wileycousins/clockblock/pcb/clockblock-pcb.sch

## KiCad design pcb/clockblock-pcb.sch (2014-01-02)

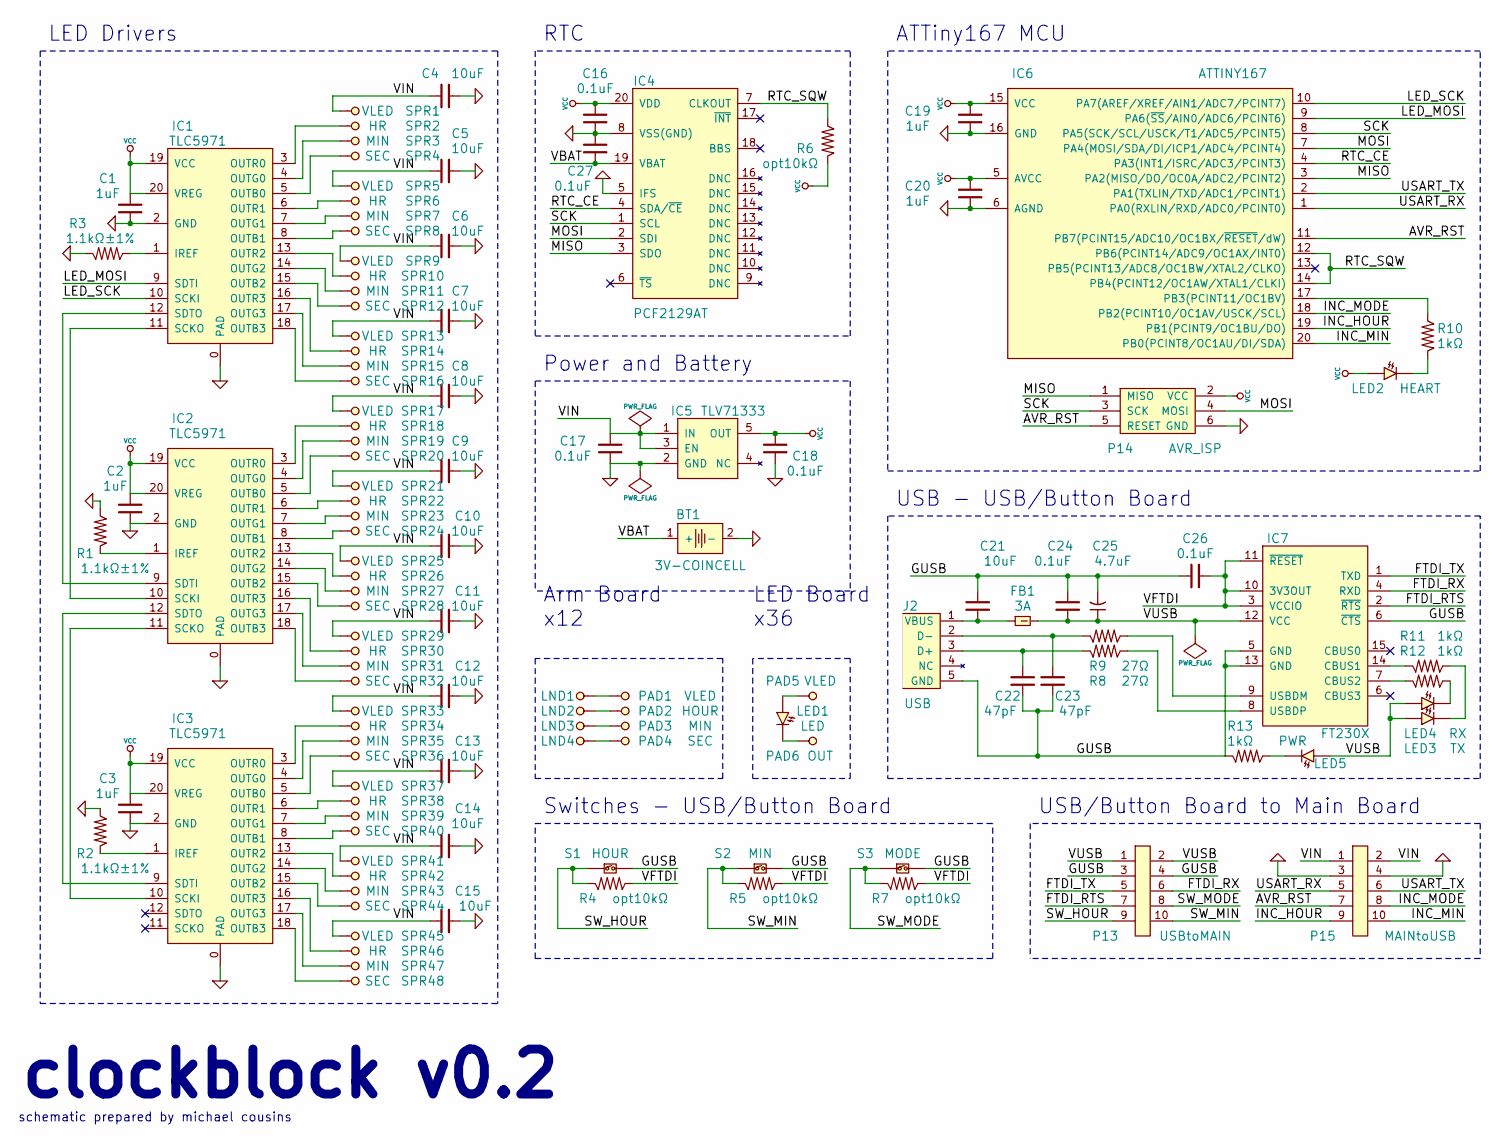
[picture p1: schematic clockblock-pcb.sch]

Parts:
BT1: 3V-COINCELL; LINX_BAT-HLD-012-SMT; Part BAT-HLD-012-SMT
C1, C2, C3, C19, C20: 1uF; 0603(1608m)
C4, C5, C6, C7, C8, C9, C10, C11, C12, C13, C14, C15, C21: 10uF; 0603(1608m)
C16, C17, C18, C24, C26, C27: 0.1uF; 0603(1608m)
C22, C23: 47pF; 0603(1608m)
C25: 4.7uF; 1206(3216m)_tant-cap; Part T491A475K010AT
FB1: 3A; 0603(1608m); Part CIC10P330NC
IC1, IC2, IC3: TLC5971; HTSSOP20; Part TLC5971PWP
IC4: PCF2129AT; SOIC20; Part PCF2129AT/2
IC5: TLV71333; SOT23-5; Part TLV71333PDBV
IC6: ATTINY167; TSSOP20; Part ATTINY167-XU
IC7: FT230X; SSOP16; Part FT230XS
J2: USB; MICROUSB_sm; Part 10118192-0001LF
LED1: LED; LED-5mm; Part TLCR5800
LED2: HEART; 0603(1608m)_led
LED3: TX; 0603(1608m)_led
LED4: RX; 0603(1608m)_led
LED5: PWR; 0603(1608m)_led
LND1: VLED; 2x3MM_SM-PAD; Part N/A
LND2: HOUR; 2x3MM_SM-PAD; Part N/A
LND3: MIN; 2x3MM_SM-PAD; Part N/A
LND4: SEC; 2x3MM_SM-PAD; Part N/A
P13: USBtoMAIN; 2x5-PIN-ARRAY_P100MIL_sm; Part 3020-10-0300-00
P14: AVR_ISP; 2x3-array; Part N/A
P15: MAINtoUSB; 2x5-PIN-ARRAY_P100MIL_sm; Part 3020-10-0300-00
PAD1, PAD5: VLED; 3x5MM_SM-PAD; Part N/A
PAD2: HOUR; 3x5MM_SM-PAD; Part N/A
PAD3: MIN; 3x5MM_SM-PAD; Part N/A
PAD4: SEC; 3x5MM_SM-PAD; Part N/A
PAD6: OUT; 3x5MM_SM-PAD; Part N/A
R1, R2, R3: 1.1kΩ±1%; 0603(1608m)
R4, R5, R6, R7: opt10kΩ; 0603(1608m)
R8, R9: 27Ω; 0603(1608m)
R10, R11, R12, R13: 1kΩ; 0603(1608m)
S1: HOUR; SPST_6MM_sm; Part FSM4JSMA
S2: MIN; SPST_6MM_sm; Part FSM4JSMA
S3: MODE; SPST_6MM_sm; Part FSM4JSMA
SPR1: VLED; TE_1551573-5_SPRING-FINGER; Part 1551573-5
SPR2: HR; TE_1551573-5_SPRING-FINGER; Part 1551573-5
SPR3: MIN; TE_1551573-5_SPRING-FINGER; Part 1551573-5
SPR4: SEC; TE_1551573-5_SPRING-FINGER; Part 1551573-5
SPR5, SPR9, SPR13, SPR17, SPR21, SPR25, SPR29, SPR33, SPR37, SPR41, SPR45: VLED; TE_1551573-5_SPRING-FINGER
SPR6, SPR10, SPR14, SPR18, SPR22, SPR26, SPR30, SPR34, SPR38, SPR42, SPR46: HR; TE_1551573-5_SPRING-FINGER
SPR7, SPR11, SPR15, SPR19, SPR23, SPR27, SPR31, SPR35, SPR39, SPR43, SPR47: MIN; TE_1551573-5_SPRING-FINGER
SPR8, SPR12, SPR16, SPR20, SPR24, SPR28, SPR32, SPR36, SPR40, SPR44, SPR48: SEC; TE_1551573-5_SPRING-FINGER

Connections:
AVR_RST: IC6.11 (PB7(PCINT15/ADC10/OC1BX/~RESET~/dW)), P14.5 (RESET), P15.7
FTDI_RTS: IC7.2 (~RTS~), P13.7
FTDI_RX: IC7.4 (RXD), P13.6
FTDI_TX: IC7.1 (TXD), P13.5
GND: BT1.2 (-), C1.1, C2.1, C3.1, C4.2, C5.2, C6.2, C7.2, C8.2, C9.2, C10.2, C11.2, C12.2, C13.2, C14.2, C15.2, C16.1, C17.1, C18.1, C19.2, C20.2, C27.2, IC1.0 (PAD), IC1.2 (GND), IC2.0 (PAD), IC2.2 (GND), IC3.0 (PAD), IC3.2 (GND), IC4.5 (IFS), IC4.8 (VSS(GND)), IC5.2 (GND), IC6.6 (AGND), IC6.16 (GND), P14.6 (GND), P15.3, P15.4, R1.2, R2.2, R3.1
GUSB: C21.1, C22.1, C23.1, C24.2, C25.2, C26.1, IC7.5 (GND), IC7.6 (CBUS3), IC7.13 (GND), J2.5 (GND), P13.3, P13.4, R13.1, S1.2, S2.2, S3.2
INC_HOUR: IC6.19 (PB1(PCINT9/OC1BU/DO)), P15.9
INC_MIN: IC6.20 (PB0(PCINT8/OC1AU/DI/SDA)), P15.10
INC_MODE: IC6.18 (PB2(PCINT10/OC1AV/USCK/SCL)), P15.8
LED_MOSI: IC1.9 (SDTI), IC6.9 (PA6(~SS~/AIN0/ADC6/PCINT6))
LED_SCK: IC1.10 (SCKI), IC6.10 (PA7(AREF/XREF/AIN1/ADC7/PCINT7))
MISO: IC4.3 (SDO), IC6.3 (PA2(MISO/DO/OC0A/ADC2/PCINT2)), P14.1 (MISO)
MOSI: IC4.2 (SDI), IC6.7 (PA4(MOSI/SDA/DI/ICP1/ADC4/PCINT4)), P14.4 (MOSI)
unnamed: C21.2, FB1.1, J2.1 (VBUS)
unnamed: C22.2, J2.3 (D+), R9.1
unnamed: C23.2, J2.2 (D-), R8.1
unnamed: IC1.1 (IREF), R3.2
unnamed: IC1.3 (OUTR0), SPR2.1
unnamed: IC1.4 (OUTG0), SPR3.1
unnamed: IC1.5 (OUTB0), SPR4.1
unnamed: IC1.6 (OUTR1), SPR6.1
unnamed: IC1.7 (OUTG1), SPR7.1
unnamed: IC1.8 (OUTB1), SPR8.1
unnamed: IC1.11 (SCKO), IC2.10 (SCKI)
unnamed: IC1.12 (SDTO), IC2.9 (SDTI)
unnamed: IC1.13 (OUTR2), SPR10.1
unnamed: IC1.14 (OUTG2), SPR11.1
unnamed: IC1.15 (OUTB2), SPR12.1
unnamed: IC1.16 (OUTR3), SPR14.1
unnamed: IC1.17 (OUTG3), SPR15.1
unnamed: IC1.18 (OUTB3), SPR16.1
unnamed: IC2.1 (IREF), R1.1
unnamed: IC2.3 (OUTR0), SPR18.1
unnamed: IC2.4 (OUTG0), SPR19.1
unnamed: IC2.5 (OUTB0), SPR20.1
unnamed: IC2.6 (OUTR1), SPR22.1
unnamed: IC2.7 (OUTG1), SPR23.1
unnamed: IC2.8 (OUTB1), SPR24.1
unnamed: IC2.11 (SCKO), IC3.10 (SCKI)
unnamed: IC2.12 (SDTO), IC3.9 (SDTI)
unnamed: IC2.13 (OUTR2), SPR26.1
unnamed: IC2.14 (OUTG2), SPR27.1
unnamed: IC2.15 (OUTB2), SPR28.1
unnamed: IC2.16 (OUTR3), SPR30.1
unnamed: IC2.17 (OUTG3), SPR31.1
unnamed: IC2.18 (OUTB3), SPR32.1
unnamed: IC3.1 (IREF), R2.1
unnamed: IC3.3 (OUTR0), SPR34.1
unnamed: IC3.4 (OUTG0), SPR35.1
unnamed: IC3.5 (OUTB0), SPR36.1
unnamed: IC3.6 (OUTR1), SPR38.1
unnamed: IC3.7 (OUTG1), SPR39.1
unnamed: IC3.8 (OUTB1), SPR40.1
unnamed: IC3.13 (OUTR2), SPR42.1
unnamed: IC3.14 (OUTG2), SPR43.1
unnamed: IC3.15 (OUTB2), SPR44.1
unnamed: IC3.16 (OUTR3), SPR46.1
unnamed: IC3.17 (OUTG3), SPR47.1
unnamed: IC3.18 (OUTB3), SPR48.1
unnamed: IC6.17 (PB3(PCINT11/OC1BV)), R10.2
unnamed: IC7.7 (CBUS2), R12.1
unnamed: IC7.8 (USBDP), R9.2
unnamed: IC7.9 (USBDM), R8.2
unnamed: IC7.14 (CBUS1), R11.1
unnamed: LED1.1 (C), PAD6.1
unnamed: LED1.2 (A), PAD5.1
unnamed: LED2.1 (C), R10.1
unnamed: LED3.1 (C), R11.2
unnamed: LED4.1 (C), R12.2
unnamed: LED5.1 (C), R13.2
unnamed: LND1.1, PAD1.1
unnamed: LND2.1, PAD2.1
unnamed: LND3.1, PAD3.1
unnamed: LND4.1, PAD4.1
RTC_CE: IC4.4 (SDA/~CE~), IC6.4 (PA3(INT1/ISRC/ADC3/PCINT3))
RTC_SQW: IC4.7 (CLKOUT), IC6.12 (PB6(PCINT14/ADC9/OC1AX/INT0)), IC6.14 (PB4(PCINT12/OC1AW/XTAL1/CLKI)), R6.2
SCK: IC4.1 (SCL), IC6.8 (PA5(SCK/SCL/USCK/T1/ADC5/PCINT5)), P14.3 (SCK)
SW_HOUR: P13.9, R4.1, S1.1
SW_MIN: P13.10, R5.1, S2.1
SW_MODE: P13.8, R7.1, S3.1
USART_RX: IC6.1 (PA0(RXLIN/RXD/ADC0/PCINT0)), P15.5
USART_TX: IC6.2 (PA1(TXLIN/TXD/ADC1/PCINT1)), P15.6
VBAT: BT1.1 (+), C27.1, IC4.19 (VBAT)
VCC: C1.2, C2.2, C3.2, C16.2, C18.2, C19.1, C20.1, IC1.19 (VCC), IC1.20 (VREG), IC2.19 (VCC), IC2.20 (VREG), IC3.19 (VCC), IC3.20 (VREG), IC4.20 (VDD), IC5.5 (OUT), IC6.5 (AVCC), IC6.15 (VCC), LED2.2 (A), P14.2 (VCC), R6.1
VFTDI: C26.2, IC7.3 (VCCIO), IC7.10 (3V3OUT), IC7.11 (~RESET~), R4.2, R5.2, R7.2
VIN: C4.1, C5.1, C6.1, C7.1, C8.1, C9.1, C10.1, C11.1, C12.1, C13.1, C14.1, C15.1, C17.2, IC5.1 (IN), IC5.3 (EN), P15.1, P15.2, SPR1.1, SPR5.1, SPR9.1, SPR13.1, SPR17.1, SPR21.1, SPR25.1, SPR29.1, SPR33.1, SPR37.1, SPR41.1, SPR45.1
VUSB: C24.1, C25.1, FB1.2, IC7.12 (VCC), LED3.2 (A), LED4.2 (A), LED5.2 (A), P13.1, P13.2

Notes on the sheet:
LED Drivers
ATTiny167 MCU
Power and Battery
Switches - USB/Button Board
USB - USB/Button Board
LED Board x36
clockblock v0.2
RTC
Arm Board x12
schematic prepared by michael cousins
USB/Button Board to Main Board
