wileycousins/clockblock/(notices)

Notices in the files:
pcb/clockblock-pcb.sch:
released under the terms of the Creative Commons Attribution Share-Alike 3.0 license
